tg44/HALE-H8E10/docs/decisions.md

# Design decisions

Short records of the choices made so far and why. Add a new entry rather
than editing an old one when something changes.

## D1. Scope: pad controller first, keybed later

Started as "MPK-mini clone with motorized X32 faders". Motorized faders need
an H-bridge, PID loop, capacitive touch and a ~10 V rail that USB can't
supply from a laptop; they pushed the project into custom power and a much
larger firmware. Dropped for v1. An LPD8-sized board (8 hall keys, 10
encoders, display) is cheap to get wrong and the sensing/encoder/MIDI code
carries straight to a 25-key version.

Every key is a hall key. There are no mechanical/hot-swap switches on the
board; menu and mode functions use the encoder pushes and the keys
themselves.

## D2. Hall-effect keys, MX form factor

Gateron KS-20 magnetic switches (4.1 mm travel, 30 gf, SMD LED window) with
a linear hall sensor on the PCB. Gives velocity (time between two
thresholds), aftertouch (travel past actuation) and rapid trigger. MX
keycaps are fine for pads; a piano feel is explicitly out of scope — if a
playable keybed is wanted later, design a grid with isomorphic layouts
rather than imitate piano geometry.

## D3. Sensor: Honeywell SS39ET (SOT-23)

SOT-23 sits flat on the bottom of the board under the switch and is easy to
solder. Ratiometric output, so it's powered from the same filtered 3.3 V
rail the ADC references. Cheaper clones (OH49E-S, HSS39ET) are the fallback
if stock runs out; HAL9303SO is the higher-sensitivity option.

## D4. MCU: Seeed XIAO ESP32S3 Plus, flush-mounted on the bottom

Needs native USB OTG for class-compliant USB-MIDI, which rules out every
C-series ESP (C3/C5/C6 only have USB-Serial/JTAG; C5 OTG has no IDF driver
as of 2026). S3 gives USB-MIDI + BLE-MIDI + Wi-Fi web UI on one chip. The
Plus exposes 20 GPIO via half-pitch castellations, reachable with an iron
when soldered flush, which is how it's mounted (socketed would leave only
11 pins). It goes on the bottom with the rest of the soldered parts, so the
top of the board carries only switches, encoders and the display.

## D5. External ADC: MCP3208

The S3's ADC is noisy and non-linear at the ends. An 8-channel 12-bit SPI
ADC replaces both the mux and the bad ADC, has a VREF pin for the
ratiometric trick, and is cheap and easy to get. ADS7953 is the 16-channel
upgrade for a 33-key board.

## D6. I/O expansion: 2 × MCP23017

10 encoders × (A, B, push) = 30 inputs. Two MCP23017s on I2C with internal
pull-ups and wired-OR interrupts, 2 pins spare. (Alternative: four chained
74HC165 on SPI, polled at 2 kHz — deterministic, no interrupts; keep in mind
if I2C latency ever shows.) Encoders decode with a Gray-code state table.

## D7. Encoders: all detented push-encoders, 24/24

Mixed detent/smooth was considered (detent for browse, smooth for EQ/macros).
Rejected: smooth encoders are hard to push without a stray step, and all
ten need push (push-to-reset stands in for a centre detent on EQ knobs).
Elektron uses detented push-encoders everywhere, with acceleration for
sweeps and a fine mode for slow trims. Soft-detent Bourns PEC11R-4215F-S0024
or Alps EC11E light-detent; sample both before buying ten.

## D8. LEDs: SK6812MINI-E(A), reverse mount

Reverse-mount so they sit on the bottom with the rest of the SMD and shine
up through a cutout. The -EA and plain -E variants share the footprint;
either works for hand soldering. (-EA is the one a fab's economic assembly
line accepts, which only matters for a later assembled rev.) 3.3 V data
through a 74AHCT1G125 level shifter.

## D9. Display: generic 1.54" 240×240 ST7789, 8-pin

Has a CS pin, so it can share SPI; socketed on a header with four M2
standoffs so a swap is a footprint change. Full mechanical drawing is in
docs/display.md. 0.96" OLEDs were considered and are fine for a settings
display; the IPS panel is the cheap way to look expensive.

## D10. v0 is hand-soldered, all soldering on the bottom

One board, soldered by a person who does SMD professionally. No fab
assembly for v0: it would add setup and feeder fees for a single unit and
tie part choices to one fab's stock list. Everything soldered sits on the
bottom of a 1.2 mm board (SMD and the XIAO); the top has only switches,
encoders and the display socket. Passives are 0603 with hand-solder pads.
LCSC numbers stay in the symbols so an assembled rev remains an option.

## D11. Power from USB via the XIAO

Total draw < 600 mA (S3 Wi-Fi bursts ~400 mA, 20 LEDs dimmed, sensors,
display). 5 V comes from the XIAO's 5V pin; a dedicated 3.3 V LDO on the
board feeds sensors, ADC and display rather than loading the XIAO's small
regulator. Ferrite + caps isolate the analog rail from LED switching noise.

## D12. No bench test; v0 is the test

The sensor–magnet geometry is not measured on a breadboard first. Instead:

- sensor position under the KS-20 is copied from open hall-keyboard designs
  that use the same switch family (minipad, KBHE 75HE), cross-checked
  against the KS-20 drawing;
- magnet polarity doesn't need to be known: the SS39ET rests at VCC/2 and
  swings either way, and per-key calibration records rest and bottom-out;
- the board is cheap and hand-built, so a wrong offset costs one bare PCB
  respin and a re-solder, not an assembly order.

Accepted risk: too little swing, or saturation, on v0. If that happens the
fix is a moved footprint or a different-sensitivity sensor in the same
SOT-23 (D3).

## D13. Schematic and layout grow together

Not "finish the schematic, then lay out". Each part group is collected
(symbol, footprint, 3D model, datasheet), drawn and placed before the next
one starts, and the case is modelled alongside. Mechanical fit is the
tightest constraint on this board (key pitch, knob clearance, display
height, XIAO under the board), so it gets checked from the first placed
part instead of after routing. See docs/plan.md.

## D14. Board thickness 1.6 mm, not 1.2 mm

Replaces the 1.2 mm in D10 and pcb-notes. 1.2 mm was chosen to bring the
sensor closer to the magnet, assuming the signal would be weak. The
datasheets (now in hardware/libs/datasheets/) say the opposite:

- KS-20: 102 ± 15 G at rest, 905 ± 80 G at bottom-out, magnet face
  0.3 mm above the PCB top at bottom-out. The drawing shows a standard
  ~1.6 mm PCB, so 905 G is most likely measured through 1.6 mm.
- SS39ET at 3.3 V: ~0.9 mV/G typical (0.27 mV/G/V nominal, up to
  ~0.35), output limited to ~0.95–1.05 V from either rail, so it clips at
  roughly 520–780 G. Even at 5 V the guaranteed range is only ±650 G.

So the sensor clips over the last part of the travel at 1.6 mm already;
1.2 mm would add roughly 10–40 % more field (dipole estimate) and clip
earlier. 1.6 mm costs nothing and keeps more of the travel linear.
Velocity (two thresholds high in the travel) is unaffected by clipping;
aftertouch range near bottom-out is what's at stake. Still the D12
accepted risk; the remaining fix is a lower-sensitivity sensor (open).

## D15. Sensor: TI DRV5055A3 (replaces D3's SS39ET)

DRV5055A3QDBZR (LCSC C266128), SOT-23, on the 3.3 V analog rail. Datasheet
(TI SBAS640C) at 3.3 V: 15 mV/mT, guaranteed linear range ±88 mT, output
linear to 0.2 V from either rail, VCC/2 at rest. That is ~1.7× the SS39ET's
signal and ~2.5× its room before clipping, in the same pinout.

- Proven setup: KBHE 75HE uses DRV5055A3 at 3.3 V on a 1.6 mm board; HE60
  lists it (and SS39ET) as working with Gateron magnetic switches. Every
  open hall board checked runs its sensors at 3.3 V.
- The field under a 1.6 mm board is probably below Gateron's 905 G: TI app
  note SLYA093 models ~2.1 mm magnet-to-sensor at bottom-out and picks a
  ±80 mT part. So D14's clipping estimate was pessimistic; the SS39ET is
  borderline rather than clearly clipping. Inference, not measured.
- Bipolar on purpose. DRV5056 (unipolar, 2× the swing) was rejected: it
  reads only one pole, and HE60 reports DRV5055A3 as "inverted" with
  Gateron switches, so the pole at the sensor isn't certain. With no bench
  test (D12), a wrong guess would mean eight dead keys. DRV5055 swings
  either way; calibration flips the sign.
- Fallback for clipping: DRV5055A4 (7.5 mV/mT, ±176 mT, C266123), same
  footprint, swap per key. SS39ET (C126669) also fits the same footprint.
- Pinout identical on all three: 1 VCC, 2 OUT, 3 GND. Package bodies
  differ (SS39ET 1.60 × 2.80 mm lead span, DRV5055 TO-236 1.2–1.4 ×
  2.10–2.64 mm), so the footprint uses TI's DBZ land pattern, which holds
  both (see pcb-notes).

Ratiometric still holds: sensors and MCP3208 VREF share the 3.3 V analog
rail (D5).

## D16. Display: 2.79" 428×142 NV3007 bar above the keys (replaces D9's 1.54")

TZT / ShengYang "2.79TFT-SPI" module, [AliExpress
1005012658981762](https://www.aliexpress.com/item/1005012658981762.html).
Drawings and the comparison with the other candidates:
hardware/libs/datasheets/display/ (`2.79/`, `candidates.md`).

- Why: the 1.54" module set the case height and sat in its own column
  beside the keys; with five knobs per row the case hit the print bed
  (256 mm) and the knob pitch was capped at 26. A wide, low bar in a strip
  behind the keys frees that column: the case is ~222 × 83 and the knobs
  get 27 mm. The bar is 1.8× the 1.54"'s area (64.1 × 21.3) and spans the
  four key columns (~107 px per key label).
- Same 8-pin order (GND VDD SCL SDA RES DC CS BL) and 4-wire SPI with CS:
  SPI B in pinout.md stays. VDD 3–5 V with its own 3.3 V regulator; 3.3 V
  logic; backlight 100 mA through an on-board NPN on the BL pin (counts
  against D11's budget).
- Controller is NV3007, not ST7789: drivers exist in Arduino_GFX
  (`Arduino_NV3007`) and as community esp_lcd components
  (`lz00qs/esp_lcd_nv3007`) and LVGL; not in TFT_eSPI or LovyanGFX.
  Datasheet V1.0 in datasheets/display/: VCI 2.8–3.6 V (4.6 abs max),
  IOVCC 1.8–3.6 V; 4-line SPI write cycle ≥ 10 ns (≤ 100 MHz), read
  ≥ 150 ns.
- Mounting: male header soldered straight into the main PCB, no socket.
  The module's back-side parts (≈ 2.6, from the 6.00 max) are taller than
  the header body (2.5), so the module sits on 2 × M2 3.0 mm spacers at its
  two Ø2.5 holes; glass top at ~6.4 above the main PCB.
- Power: header VDD on the **5 V** net. VDD only feeds the module's own
  3.3 V regulator (U1), which supplies the panel and, through 3 Ω, the
  backlight LEDs (Vf ≈ 3.2). From 5 V the backlight gets a full 3.3 V and
  its ~100 mA (PWM) stays off our 3.3 V rail, which also feeds the hall
  sensors (D5). From 3.3 V, U1's dropout leaves ~3.0–3.2 V and the
  backlight runs dim. U1 dissipates ≈ (5 − 3.3) × 0.11 ≈ 0.19 W. Logic
  pins are 3.3 V either way (panel side of U1), no level shifting.
- Not verified with a part in hand. The 1.54" stays documented
  (`display/1.54/`) as the fallback.

## D17. Encoders bolted to the case top: Bourns PEC11R-4215F-S0024

Replaces D7's "PEC11R or Alps EC11E". The printed top has a 2 mm encoder
segment resting on the 6.5 mm encoder bodies; each M7 × 0.75 bushing goes
through a Ø7.4 hole and is clamped with the supplied washer (0.5) and nut
(2.0, 10 AF): 2.0 + 0.5 + 2.0 = 4.5 of the 5 mm thread. Push and twist
forces go into the case, not the solder joints (the push switch alone is
4–6 N per press), and the ten nuts lock the PCB to the case.

- The Alps EC11E has a plain, unthreaded collar (catalogues in
  datasheets/encoder/), so it can't be bolted; dropped.
- PEC11R-4215F-S0024: 24 detents / 24 pulses (one pulse per click, as D7
  assumed), 15 mm flatted shaft (tip 21.5 above the PCB, 7 mm D-flat),
  lighter detent than the EC11E. LCSC C143790.
- Still worth a sample before ordering ten (D7's point about feel).

## D18. Panel layout and a stepped, printed top

Source of truth: `case/layout.js` (every number below comes from there);
reasoning and sources: docs/layout-references.md.

- Left block: 2 × 4 keys at the front (19.05 pitch), the D16 display in a
  strip behind them. Right block: 2 × 5 encoders, 27 mm along a row
  (Intech EN16 ≈ 26.75); the rows line up with the front key row and the
  display centre line.
- Top is one printed part with two heights: the key area is the KS-20
  plate (1.5 thick, top 5.0 above the PCB, fixed by the switch clips); the
  display and encoder areas are flush at 8.5 (encoder bodies 6.5 + 2.0).
  The step has a near-full 3.5 mm fillet. A pressed keycap bottoms out at
  7.5, so the step sits outside the keycap footprint (+0.5).
- Spacing rules in layout.js: window → back edge equals front keycap →
  front edge (7.0); a 5.3 mm flat strip between the fillet and the window;
  2.0 walls and floor (PLA/PETG, 0.4 nozzle).
- The case must fit the owner's printer bed, 256 × 235 (4 mm spare for a
  skirt); layout.js refuses to build a bigger one. Now 222.0 × 82.7.

## D19. Sensor RC filter at the ADC, as resistor arrays

The 1 kΩ of each sensor's RC filter moves from the key cell to the ADC,
next to its 100 nF (replaces pcb-notes' "1 kΩ series near the sensor").

- The filter acts where the signal is sampled, and the long trace from
  the key is driven by the sensor's low-impedance output instead of being
  a 1 kΩ node, so it picks up less LED/I2C noise.
- With all eight resistors in one place they fit two 4-resistor arrays
  (Uni-Royal 4D03WGJ0102T5E, LCSC C20197, convex 0603×4: 3.2 × 1.6, 0.8
  pitch — datasheet in `datasheets/adc/`). An array can't sit next to
  sensors 19 mm apart, so this only works at the ADC.
- Cost: the sensor output now sees the trace capacitance (a few pF) with
  no resistor. TI warns against a *capacitor* directly on the output
  (§7.1.3); the datasheet gives no maximum load, so a few pF being fine is
  judgement, not a TI figure.

## D20. MCP23017 bit 7 is output-only: two encoder pushes go to the XIAO

Since datasheet revision D (2022), GPA7 and GPB7 of the MCP23017 are
output-only (the I2C part only; the SPI MCP23S17 keeps them). Two
expanders give 28 inputs, not 32, and the encoders need 30.

- Two push switches go straight to XIAO GPIOs (16 of 20 used, 4 spare).
  No extra parts. ENC1, top left, is the settings button, and the owner
  wants it on the MCU directly, so it is always one of the two.
- Rejected: MCP23S17 (moves the expanders onto the ADC's SPI bus) and a
  third MCP23017 (another SSOP-28 to hand-solder for two pins).
- The exact expander pin per encoder is left for layout, under the rules
  in pinout.md (A/B of one encoder on one port, bit 7 unused).
- The bit-7 pins remain usable as outputs; RST_LCD could move there if
  XIAO pins ever run short.

## D21. Settled at the schematic review (2026-10-15)

- **Digital 3.3 V comes from the XIAO.** The expanders, I2C and CS
  pull-ups run on the XIAO's 3V3_OUT (`+3.3V`), the same rail as the
  ESP32's I/O. Our LDO feeds only the analog rail (`+3.3VA`: sensors,
  MCP3208) through the ferrite. The two regulators are never tied
  together. The digital load is a few mA on top of the ESP32.
- **Hall footprint: KiCad's stock SOT-23**, not a hand-drawn TI DBZ
  pattern. Its pads span 0.2–1.675 mm from the centre, which holds the
  DRV5055, the A4 spare and the wider SS39ET alike (pcb-notes).
- **Pin assignment** as in pinout.md; the second MCU encoder push is
  ENC6 (front row, left), next to ENC1.
- **LED chain**: one serpentine run, keys → encoders; the last DOUT is the
  chain end. (The 2 status LEDs drawn here were dropped, D22.)

## D22. No status LEDs: 18 LEDs, ENC1 first in the chain

The two status LEDs (README's "2 status TBD") are dropped. The 2.79"
display shows status and connection; the 18 key and encoder LEDs are all
firmware-mapped and can show anything else.

- The one case the display can't cover — before it's initialised, or if
  it's dead — goes to **ENC1's LED** (the settings encoder): boot state,
  fault blink codes, recovery / Wi-Fi AP. Firmware rule: status wins
  before the display is up and on errors; otherwise it is a normal
  encoder LED.
- That only works if ENC1's LED is **first in the chain**: data can't get
  past a dead LED, so everything after one goes dark. The chain order is
  still open (plan A7); it now starts at ENC1.
- Considered: keeping the two as unfitted footprints at the chain's end
  (a free later option) and a lit "8" in a printed logo. Dropped for
  simplicity; there are plenty of LEDs.
- Fewer parts: 2 LEDs and 2 × 100 nF less, and ~70 mA less worst-case
  current.

## D23. 5 V split into switched rails; CS pull-ups follow the rails

The single `+5V` net is split behind two TI TPS22810 load switches
(2026-10-19):

- `+5V_AUX` (U1003, EN_AUX on GPIO4): the display and the ME6211 that
  makes `+3.3VA` (sensors, MCP3208). `+5V_LED` (U1004, EN_LED on GPIO42):
  the 18 LEDs and the 74AHCT1G125. `+5V` itself (VBUS) feeds only the two
  switches.
- Why: everything stays off while the ESP32 boots and enumerates, the
  LEDs can't flash garbage from a floating LED_DATA during reset (EN has a
  10 kΩ pull-down, so a reset drops the rail), and the firmware can
  power-cycle the display and the analog side.
- CT = 100 nF: ~9 ms soft start, ~20 mA inrush into the LED rail's 42 µF.
  That replaces D11/pcb-notes' 220 µF bulk electrolytic (4 × 10 µF stay).
  QOD tied to VOUT discharges a rail quickly when it's switched off.
- Pull-ups now sit on the rail of the chip they protect: ADC_CS to
  `+3.3VA` (R2001); LCD_CS has none. A pull-up to the always-on `+3.3V`
  would feed an unpowered chip through its CS pin.
- Cost: two GPIOs. Only GPIO3 (strapping) and GPIO43 (UART0 TX) are left
  free, and ADC_CS moved to GPIO44 (UART0 RX), so the debug console is
  TX-only.
- Firmware rules that come with it (pcb-notes, 5 V rails): switch a rail
  on and wait ≥ 10 ms before driving its chips' pins; make those pins
  inputs before switching off; cap LED brightness for a 500 mA port.
- Considered: EN_AUX on an RC to `+5V` (always on, soft start only) to
  save a GPIO. Kept the GPIO for now; it's the first thing to give back if
  a pin is needed.

## D24. Mounting holes: screws around the key block, pins elsewhere

12 holes on a grid (positions in pcb-notes, "Mounting holes"), 7 screws
and 5 pins (2026-10-19).

- The KS-20s are clipped into the plate but not soldered, so nothing else
  holds the left half of the board against the top. The key block gets
  screws on all four sides (two on the keys/display step wall, the step
  wall corner and its front end, the front-left corner). Their bosses are
  3.5 mm, the gap the switch housing fills, so the screws set the
  magnet-to-sensor distance.
- The encoder half is already clamped by the ten M7 nuts (D17): two
  screws hold the tray, the rest are pins.
- Pins where a boss doesn't fit: H1002 (2.3 mm to the switch courtyards)
  and H1012 under the display, where the top can't reach the board. The
  latter is a tray pin that supports the XIAO/USB-C corner.
- Grid: rows 65.2 / 95.8 / 134.8 (edge rows 4.04 mm in, symmetric about
  the board centre), columns on the key-block centre ± 16.5, the step
  wall and the encoder gaps, so the case model can use the same numbers.
  Corner holes sit at least 2.7 mm from the R5 corner arc.

## D25. Firmware: PlatformIO + pioarduino, Arduino framework; USB-MIDI last

Settled 2026-10-22, before C0. Replaces "ESP-IDF (or Arduino-ESP32)" in
firmware/README.md. Details in firmware/docs/.

- C++, not Rust. esp-hal (Rust) is usable on the S3, but there is no
  NV3007 driver, BLE-MIDI and the web page would be written by hand, and
  board bring-up should run on known-good library code.
- PlatformIO for the workflow (already used in luminotaxis), through the
  pioarduino fork: stock `platform-espressif32` is stuck on Arduino-ESP32
  2.x. The platform is pinned to a release tag.
- Arduino framework, because the planned libraries (Arduino_GFX
  `Arduino_NV3007`, BLE-MIDI, ESPAsyncWebServer) are Arduino libraries.
  `framework = arduino, espidf` stays open if an IDF setting is needed.
- TinyUSB takes over the USB port and with it the serial console and
  auto-reset flashing. So development runs on the `xiao` env
  (USB-Serial-JTAG), MIDI goes to the log / BLE, and USB-MIDI is switched
  on last (`xiao-usbmidi`, C13), after OTA works. A short C1 spike checks
  the mode switch and recovery early. A one-boot "reboot without MIDI"
  menu item is planned (unverified until C1).

## D26. Mini test board (H4E2) before v0; amends D12

Settled 2026-10-24. D12 ("no bench test, v0 is the test") no longer holds
in full: a small board is built first.

- What it tests: the footprints (KS-20 pegs with the SOT-23 sensor
  under it, the SK6812MINI-EA reverse-mount cutout, PEC11R, MCP3208
  SOIC-16, the resistor array), the hall circuit with the D19 RC filter
  at the ADC, the LDO + ferrite analog rail, encoders and the display.
  Four keys leave room to put the DRV5055A3, the A4 spare and the SS39ET
  side by side under the same switch.
- Not tested: the TPS22810 load switches (no EU distributor stock on
  2026-10-22).
- Layout: the H8E10's left 2×2 keys and the 2.79" display at the same
  positions relative to each other, plus 1–4 encoders. Same part sizes and
  spacing rules as the big board. Picked: `h4e2-stack`, two encoders
  stacked in the free key slot (27 apart, case 91.0 × 82.7, no wider
  than the display needs). The key well's wall leaves the same gap right
  of the keys as the case edge does left of them (7.9), and the column is
  centred on the flat top between the step slope and the case edge (9.8
  each side). Accepted cost: the back knob is 4.9 mm in
  front of the screen window and hides its lower-right corner unless
  viewed from steeply above; the encoder positions differ from the
  H8E10's, so the mini doesn't check the big board's encoder/step-wall
  fit. The other candidates stay in `case/mini/` (`VARIANTS`).
- Sourcing: as few LCSC line types as possible. Since 2026-07-01 a
  parcel under €150 from outside the EU pays €3 duty per tariff line, so
  loose passives from LCSC cost more in duty than in parts. Mouser has
  everything but the LEDs and the TPS22810; the LED comes from LCSC
  because the footprint test needs the real part.
- The case files were reorganised for it: shared sizes and builders in
  `case/lib/`, the full board in `case/h8e10/` (D18's `case/layout.js` is
  now `case/h8e10/layout.js`, spacing numbers in `case/lib/parts.js`),
  the mini in `case/mini/`. Its KiCad project is `hardware/H4E2/`.

## D27. Mini assembly: screws on the right, nothing on the left

Settled 2026-10-25, for the mini (D26). Replaces D24's bosses there; the
H8E10 keeps D24 for now.

- D24's 3.5 mm bosses hang below the top's underside. The top is printed
  bottom-up (top layer last, for the finish), so they would be the first
  layer and leave the switch plate in the air. The same holds for the
  H8E10's key-area bosses (H1001, H1003–H1006): that needs rethinking
  before v0.
- Left side: no room for inserts (the switch plate is 1.5 mm, the screen
  strip is hollow over the glass) and no screws near the sensors. The top
  just rests on the tray walls there, as everywhere: the screws and nuts
  already fix it in x, y and z, and key presses push down onto the walls.
  An L-shaped tray wall without a lip was tried and dropped: it held
  nothing the plain wall doesn't. Known weak spot: pulling a keycap lifts
  the front-left of the switch plate (about 70 mm from the nearest
  fixing); hold the board down. A hooked left wall can follow if that is
  a problem in practice.
- Right side: two M2 screws from under the tray into heat-set inserts in
  the top's solid encoder area (front corner, and in front of the screen
  glass), plus the two encoder nuts. Brass or nylon screws.
- The PCB is not screwed: tray towers hold it from below (centre of the
  key block, front-left corner, the screw columns), two of them with a
  pin through a PCB hole under the screen to locate it. Its bottom side
  needs Ø6 keep-out spots there.
- Assembly, all straight down: tray, PCB on its towers, top (on the tray
  walls, encoder bushings through their holes), keys clipped in, encoder
  nuts, screws from below.
- Insert hole Ø3.2 × 4 is a typical value, not from the insert's
  datasheet.
