tg44/HALE-H8E10/firmware/docs/features/display/tasks.md

# Display tasks

## Now

## Next

- [ ] decide the drawing layer that renders in `native` (screens to PNG)
- [ ] first screens: play, status

## Needs the board

- [ ] C6: init, rotation, backlight (LCD-M1 … LCD-M4)

## Done
