tg44/HALE-H8E10/firmware/docs/features/encoders/tasks.md

# Encoder tasks

## Now

## Next

- [ ] Gray-code decoder with tests on recorded pin sequences
- [ ] acceleration and push logic with tests

## Needs the board

- [ ] C7: expander setup, interrupts, all ten encoders (ENC-M1 … ENC-M5)

## Done
