tg44/HALE-H8E10/firmware/docs/features/keys/tasks.md

# Key tasks

## Now

## Next

- [ ] simulated sensor traces (rest, slow press, fast press, partial
      press, hold, release) as test fixtures
- [ ] key engine against those traces in `native`

## Needs the board

- [ ] C8: ADC raw dump, channel map, swing per key (KEY-M1 … KEY-M4, KEY-M6)
- [ ] record real traces, replace the simulated fixtures
- [ ] C9: thresholds from real data
- [ ] re-check in the case (KEY-M5)

## Done
