tg44/HALE-H8E10/firmware/docs/features/leds/tasks.md

# LED tasks

## Now

## Next

- [ ] status light patterns as data, testable in `native`
- [ ] brightness cap as a function of the frame, testable in `native`

## Needs the board

- [ ] C5: RMT driver, rail on/off, chain walk (LED-M1 … LED-M4)
- [ ] measure current, set the cap (SYS-M11)

## Done
