tg44/HALE-H8E10/firmware/docs/features/midi/tasks.md

# MIDI tasks

## Now

## Next

- [ ] C1: USB-MIDI spike (with system)
- [ ] output interface + log output, tests in `native`
- [ ] message encoding (MIDI bytes, USB-MIDI packets, BLE-MIDI packets)
      with tests
- [ ] C3: BLE-MIDI on a bare XIAO
- [ ] C10: mapping, tests in `native`

## Needs the board

- [ ] C13: USB-MIDI output (needs OTA, see usb.md)

## Done
