tg44/HALE-H8E10/firmware/docs/features/settings/checks.md

# Settings checks

| ID | Check | How | Expected (source) | Board | Result | Date |
|---|---|---|---|---|---|---|
| SET-M1 | Settings survive a power cycle | change a setting, unplug, plug in | setting kept | | | |
| SET-M2 | Recovery boot | hold ENC1 while plugging in | defaults + Wi-Fi AP; stored settings intact until confirmed (on-device-menu.md) | | | |
| SET-M3 | Settings mode by hand | enter, move, change, leave | works as on-device-menu.md; no MIDI sent while in it | | | |
