tg44/HALE-H8E10/firmware/docs/features/settings/tasks.md

# Settings tasks

## Now

## Next

- [ ] C2: settings model + serialization, tests in `native`
- [ ] C2: NVS storage on a bare XIAO
- [ ] menu state machine in `native` (from on-device-menu.md)

## Needs the board

- [ ] C11: settings mode on the device (keys, ENC1, display, LEDs)

## Done
