tg44/HALE-H8E10/firmware/docs/features/web/checks.md

# Web checks

| ID | Check | How | Expected (source) | Board | Result | Date |
|---|---|---|---|---|---|---|
| WEB-M1 | Wi-Fi signal in the case | RSSI on the status page, case closed, a few metres from the router | OPEN: target RSSI; record it | | | |
| WEB-M2 | OTA update | upload a new build over Wi-Fi | new version boots, settings kept | | | |
| WEB-M3 | Access point | recovery boot, connect a phone | settings page reachable | | | |
