tg44/HALE-H8E10/firmware/docs/features/web/tasks.md

# Web tasks

## Now

## Next

- [ ] C4: Wi-Fi connect + AP on a bare XIAO
- [ ] C4: OTA update on a bare XIAO
- [ ] C4: settings page skeleton against the settings model
- [ ] logs over Wi-Fi

## Needs the board

- [ ] C12: MIDI map editor, calibration view

## Done
