tg44/HALE-H8E10/docs/img/display-1.54-front.png

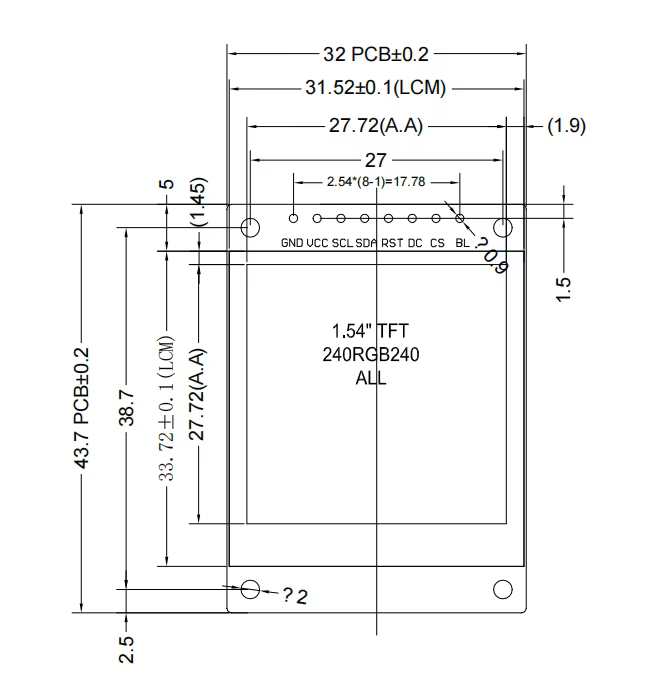
docs/img/display-1.54-front.png
