tg44/HALE-H8E10/hardware/H4E2/H4E2.kicad_pcb

## KiCad design hardware/H4E2/H4E2.kicad_pcb (2026-10-26)

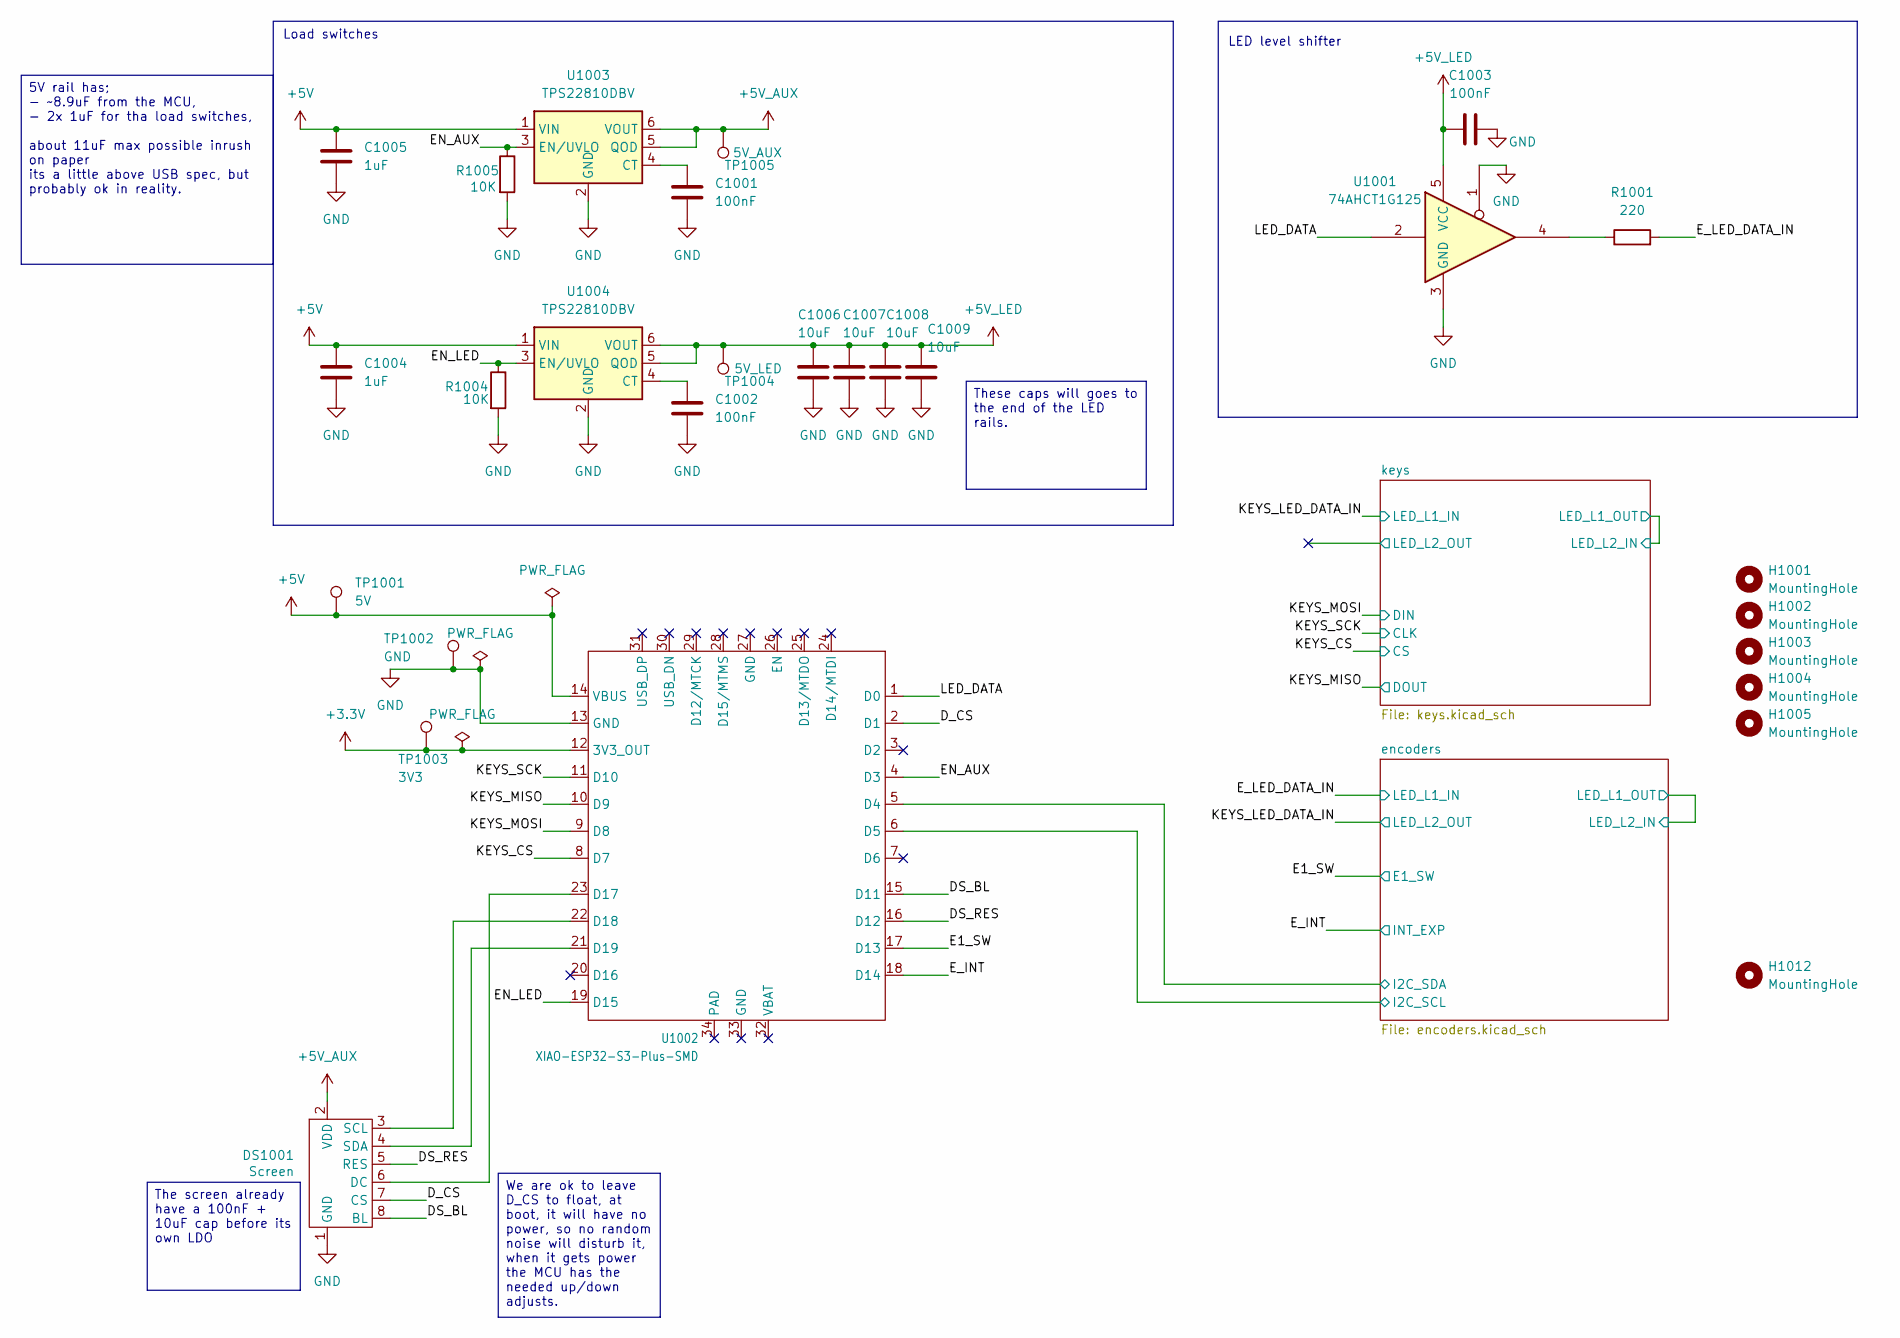
[picture p3: schematic H4E2.kicad_sch, HALE-H4E2]

Parts:
C1001, C1002, C1003: 100nF; C_0603_1608Metric_Pad1.08x0.95mm_HandSolder; LCSC C14663
C1004, C1005: 1uF; C_0603_1608Metric_Pad1.08x0.95mm_HandSolder; LCSC C15849
C1006, C1007, C1008, C1009: 10uF; C_0805_2012Metric_Pad1.18x1.45mm_HandSolder; LCSC C15850
DS1001: Screen; Display_2.79_NV3007
H1001, H1002, H1003, H1004, H1005, H1012: MountingHole; MountingHole_2.2mm_M2
R1001: 220; R_0603_1608Metric_Pad0.98x0.95mm_HandSolder; LCSC C22962
R1004, R1005: 10K; R_0603_1608Metric_Pad0.98x0.95mm_HandSolder; LCSC C25804
TP1001: 5V; TestPoint_Pad_D2.0mm
TP1002: GND; TestPoint_Pad_D2.0mm
TP1003: 3V3; TestPoint_Pad_D2.0mm
TP1004: 5V_LED; TestPoint_Pad_D2.0mm
TP1005: 5V_AUX; TestPoint_Pad_D2.0mm
U1001: 74AHCT1G125; SOT-23-5; LCSC C7484
U1002: XIAO-ESP32-S3-Plus-SMD; LCSC C47997983
U1003, U1004: TPS22810DBV; SOT-23-6; LCSC C205990

Connections:
+3.3V: TP1003.1 (1_1), U1002.12 (3V3_OUT); also elsewhere on the board
+5V: C1004.1, C1005.1, TP1001.1 (1_1), U1002.14 (VBUS), U1003.1 (VIN), U1004.1 (VIN)
+5V_AUX: DS1001.2 (VDD), TP1005.1 (1_1), U1003.5 (QOD), U1003.6 (VOUT); also elsewhere on the board
+5V_LED: C1003.2, C1006.1, C1007.1, C1008.1, C1009.1, TP1004.1 (1_1), U1001.5 (VCC), U1004.5 (QOD), U1004.6 (VOUT); also elsewhere on the board
/DS_BL: DS1001.8 (BL), U1002.15 (D11)
/DS_RES: DS1001.5 (RES), U1002.16 (D12)
/D_CS: DS1001.7 (CS), U1002.2 (D1)
/E1_SW: U1002.17 (D13); also elsewhere on the board
/EN_AUX: R1005.1, U1002.4 (D3), U1003.3 (EN/UVLO)
/EN_LED: R1004.1, U1002.19 (D15), U1004.3 (EN/UVLO)
/E_INT: U1002.18 (D14); also elsewhere on the board
/E_LED_DATA_IN: R1001.2; also elsewhere on the board
/KEYS_CS: U1002.8 (D7); also elsewhere on the board
/KEYS_MISO: U1002.10 (D9); also elsewhere on the board
/KEYS_MOSI: U1002.9 (D8); also elsewhere on the board
/KEYS_SCK: U1002.11 (D10); also elsewhere on the board
/LED_DATA: U1001.2, U1002.1 (D0)
/encoders/I2C_SCL: U1002.6 (D5); also elsewhere on the board
/encoders/I2C_SDA: U1002.5 (D4); also elsewhere on the board
GND: C1001.2, C1002.2, C1003.1, C1004.2, C1005.2, C1006.2, C1007.2, C1008.2, C1009.2, DS1001.1 (GND), R1004.2, R1005.2, TP1002.1 (1_1), U1001.1, U1001.3 (GND), U1002.13 (GND), U1003.2 (GND), U1004.2 (GND); also elsewhere on the board
unnamed: DS1001.6 (DC), U1002.23 (D17)
unnamed: DS1001.3 (SCL), U1002.22 (D18)
unnamed: DS1001.4 (SDA), U1002.21 (D19)
unnamed: R1001.1, U1001.4
unnamed: C1001.1, U1003.4 (CT)
unnamed: C1002.1, U1004.4 (CT)

Notes on the sheet:
The screen already have a 100nF + 10uF cap before its own LDO
We are ok to leave D_CS to float, at boot, it will have no power, so no random noise will disturb it, when it gets power the MCU has the needed up/down adjusts.
These caps will goes to the end of the LED rails.
5V rail has; - ~8.9uF from the MCU, - 2x 1uF for tha load switches, about 11uF max possible inrush on paper its a little above USB spec, but probably ok in reality.
Load switches
LED level shifter

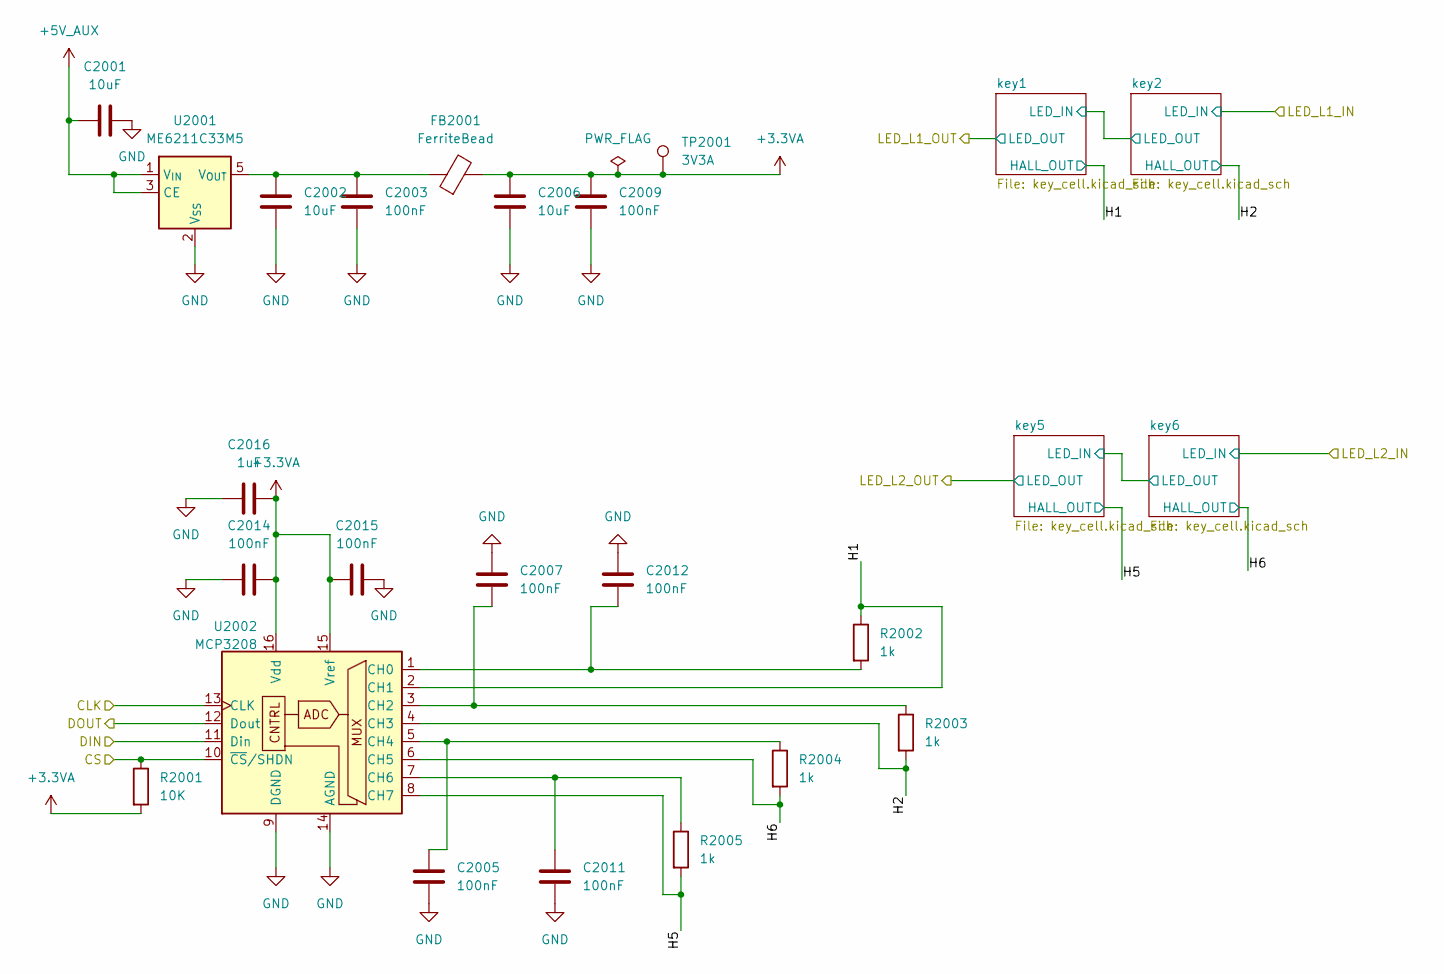
[picture p4: schematic keys.kicad_sch]

Parts:
C2001, C2002, C2006: 10uF; C_0805_2012Metric_Pad1.18x1.45mm_HandSolder; LCSC C15850
C2003, C2005, C2007, C2009, C2011, C2012, C2014, C2015: 100nF; C_0603_1608Metric_Pad1.08x0.95mm_HandSolder; LCSC C14663
C2016: 1uF; C_0603_1608Metric_Pad1.08x0.95mm_HandSolder; LCSC C15849
FB2001: FerriteBead; L_0603_1608Metric_Pad1.05x0.95mm_HandSolder; LCSC C1002
R2001: 10K; R_0603_1608Metric_Pad0.98x0.95mm_HandSolder; LCSC C25804
R2002, R2003, R2004, R2005: 1k; R_0603_1608Metric_Pad0.98x0.95mm_HandSolder
TP2001: 3V3A; TestPoint_Pad_D2.0mm
U2001: ME6211C33M5; SOT-23-5; LCSC C82942
U2002: MCP3208; SOIC-16_3.9x9.9mm_P1.27mm; LCSC C626764

Connections:
+3.3VA: C2006.1, C2009.1, C2014.1, C2015.2, C2016.1, FB2001.2, R2001.2, TP2001.1 (1_1), U2002.15 (Vref), U2002.16 (Vdd); also elsewhere on the board
+5V_AUX: C2001.1, U2001.1 (V_{IN}), U2001.3 (CE); also elsewhere on the board
/KEYS_CS: R2001.1, U2002.10 (~CS/SHDN); also elsewhere on the board
/KEYS_MISO: U2002.12 (Dout); also elsewhere on the board
/KEYS_MOSI: U2002.11 (Din); also elsewhere on the board
/KEYS_SCK: U2002.13 (CLK); also elsewhere on the board
/keys/H1: R2002.1, U2002.2 (CH1); also elsewhere on the board
/keys/H2: R2003.2, U2002.4 (CH3); also elsewhere on the board
/keys/H5: R2005.2, U2002.8 (CH7); also elsewhere on the board
/keys/H6: R2004.2, U2002.6 (CH5); also elsewhere on the board
GND: C2001.2, C2002.2, C2003.2, C2005.1, C2006.2, C2007.2, C2009.2, C2011.1, C2012.2, C2014.2, C2015.1, C2016.2, U2001.2 (V_{SS}), U2002.9 (DGND), U2002.14 (AGND); also elsewhere on the board
unnamed: C2002.1, C2003.1, FB2001.1, U2001.5 (V_{OUT})
unnamed: C2012.1, R2002.2, U2002.1 (CH0)
unnamed: C2007.1, R2003.1, U2002.3 (CH2)
unnamed: C2005.2, R2004.1, U2002.5 (CH4)
unnamed: C2011.2, R2005.1, U2002.7 (CH6)

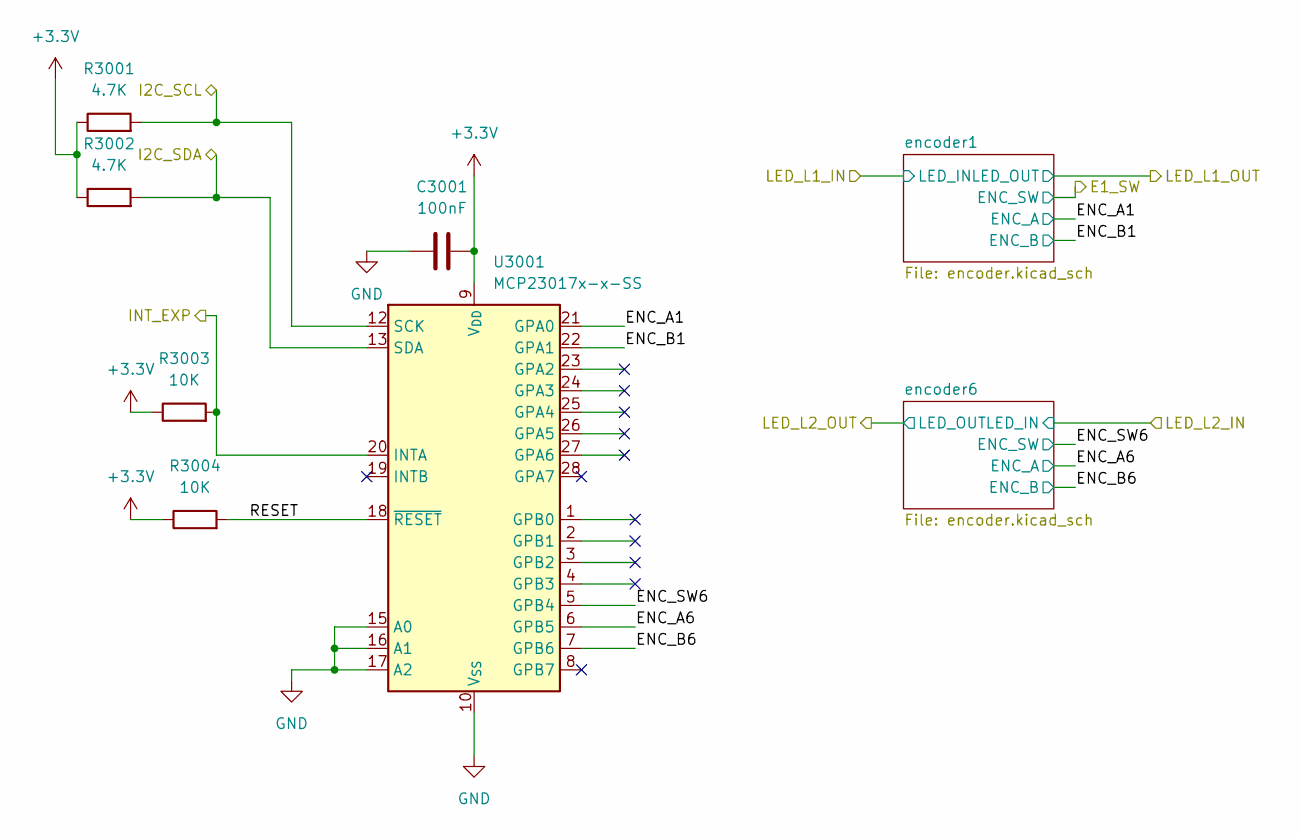
[picture p5: schematic encoders.kicad_sch]

Parts:
C3001: 100nF; C_0603_1608Metric_Pad1.08x0.95mm_HandSolder; LCSC C14663
R3001, R3002: 4.7K; R_0603_1608Metric_Pad0.98x0.95mm_HandSolder; LCSC C23162
R3003, R3004: 10K; R_0603_1608Metric_Pad0.98x0.95mm_HandSolder; LCSC C25804
U3001: MCP23017x-x-SS; SSOP-28_5.3x10.2mm_P0.65mm; LCSC C506653

Connections:
+3.3V: C3001.2, R3001.1, R3002.1, R3003.1, R3004.1, U3001.9 (V_{DD}); also elsewhere on the board
/E_INT: R3003.2, U3001.20 (INTA); also elsewhere on the board
/encoders/ENC_A1: U3001.21 (GPA0); also elsewhere on the board
/encoders/ENC_A6: U3001.6 (GPB5); also elsewhere on the board
/encoders/ENC_B1: U3001.22 (GPA1); also elsewhere on the board
/encoders/ENC_B6: U3001.7 (GPB6); also elsewhere on the board
/encoders/ENC_SW6: U3001.5 (GPB4); also elsewhere on the board
/encoders/I2C_SCL: R3001.2, U3001.12 (SCK); also elsewhere on the board
/encoders/I2C_SDA: R3002.2, U3001.13 (SDA); also elsewhere on the board
/encoders/RESET: R3004.2, U3001.18 (~RESET)
GND: C3001.1, U3001.10 (V_{SS}), U3001.15 (A0), U3001.16 (A1), U3001.17 (A2); also elsewhere on the board

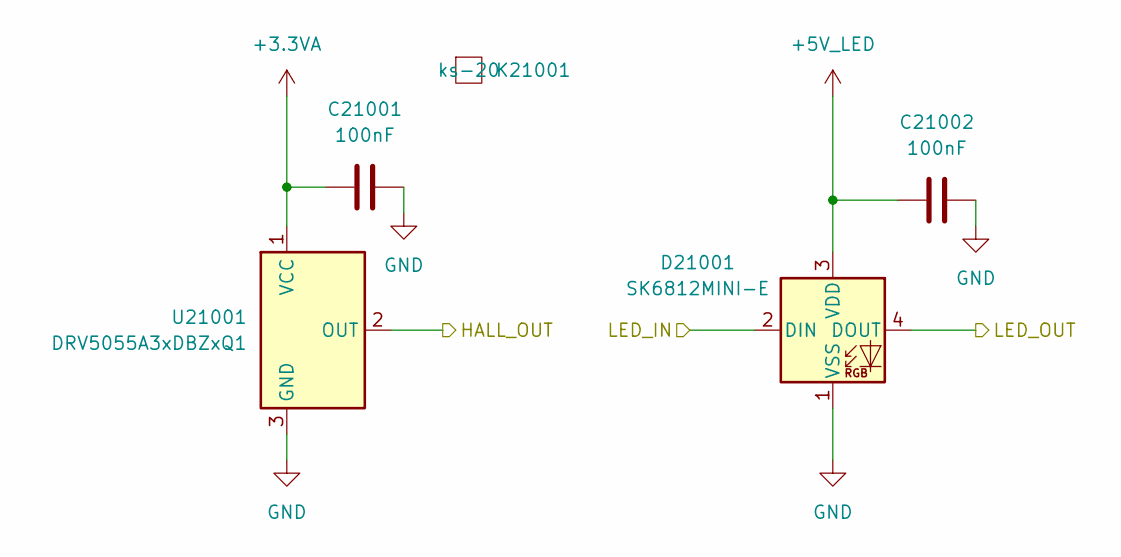
[picture p6: schematic key_cell.kicad_sch]

Parts:
C21001, C21002: 100nF; C_0603_1608Metric_Pad1.08x0.95mm_HandSolder; LCSC C14663
D21001: SK6812MINI-E; LED_SK6812MINI-E_3.2x2.8mm_P1.5mm_ReverseMount; LCSC C5149201
K21001: ks-20; Gateron_KS-20
U21001: DRV5055A3xDBZxQ1; SOT-23; LCSC C266128

Connections:
+3.3VA: C21001.1, U21001.1 (VCC); also elsewhere on the board
+5V_LED: C21002.1, D21001.3 (VDD); also elsewhere on the board
/keys/H1: U21001.2 (OUT); also elsewhere on the board
/keys/LED_L1_OUT: D21001.4 (DOUT); also elsewhere on the board
/keys/key1/LED_IN: D21001.2 (DIN); also elsewhere on the board
GND: C21001.2, C21002.2, D21001.1 (VSS), U21001.3 (GND); also elsewhere on the board

Parts of its further copies:
C22001, C22002, C25001, C25002, C26001, C26002: 100nF; C_0603_1608Metric_Pad1.08x0.95mm_HandSolder; LCSC C14663
D22001, D25001, D26001: SK6812MINI-E; LED_SK6812MINI-E_3.2x2.8mm_P1.5mm_ReverseMount; LCSC C5149201
K22001, K25001, K26001: ks-20; Gateron_KS-20
U22001, U25001, U26001: DRV5055A3xDBZxQ1; SOT-23; LCSC C266128

Connections of its further copies:
+3.3VA: C22001.1, C25001.1, C26001.1, U22001.1 (VCC), U25001.1 (VCC), U26001.1 (VCC); also elsewhere on the board
+5V_LED: C22002.1, C25002.1, C26002.1, D22001.3 (VDD), D25001.3 (VDD), D26001.3 (VDD); also elsewhere on the board
/KEYS_LED_DATA_IN: D22001.2 (DIN); also elsewhere on the board
/keys/H2: U22001.2 (OUT); also elsewhere on the board
/keys/H5: U25001.2 (OUT); also elsewhere on the board
/keys/H6: U26001.2 (OUT); also elsewhere on the board
/keys/LED_L1_OUT: D26001.2 (DIN); also elsewhere on the board
/keys/LED_L2_OUT: D25001.4 (DOUT)
/keys/key1/LED_IN: D22001.4 (DOUT); also elsewhere on the board
/keys/key5/LED_IN: D25001.2 (DIN), D26001.4 (DOUT)
GND: C22001.2, C22002.2, C25001.2, C25002.2, C26001.2, C26002.2, D22001.1 (VSS), D25001.1 (VSS), D26001.1 (VSS), U22001.3 (GND), U25001.3 (GND), U26001.3 (GND); also elsewhere on the board

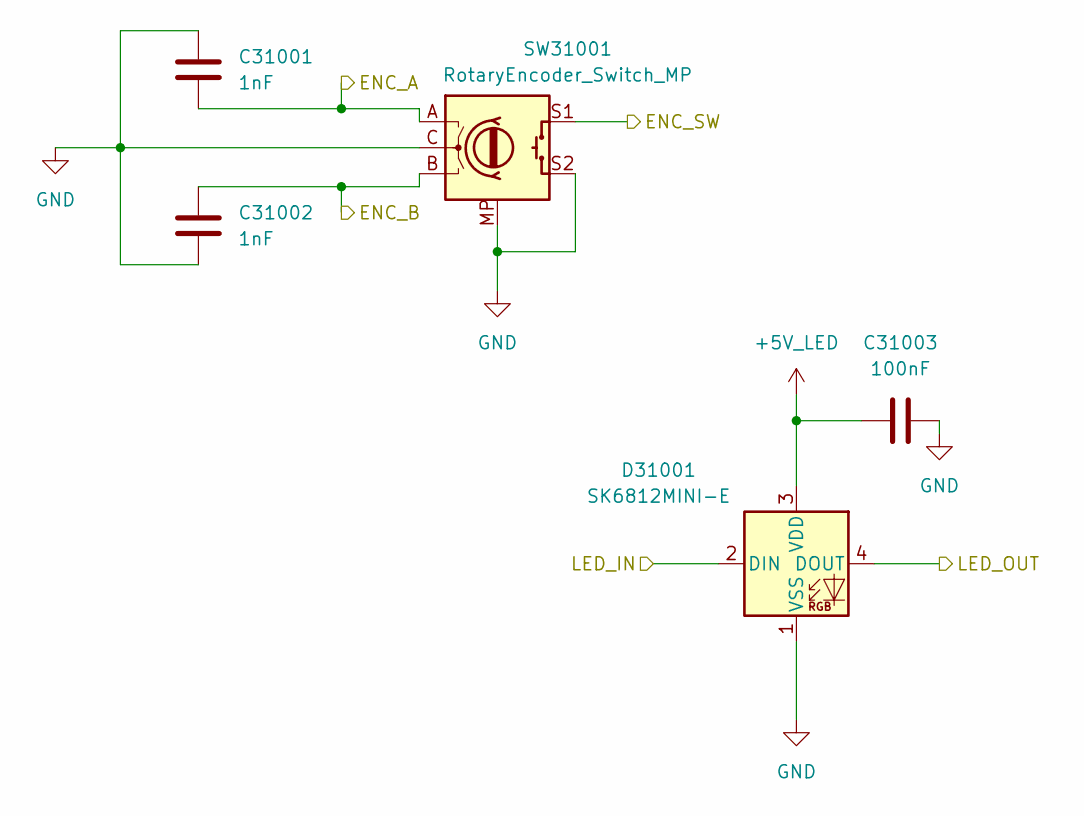
[picture p7: schematic encoder.kicad_sch]

Parts:
C31001, C31002: 1nF; C_0603_1608Metric_Pad1.08x0.95mm_HandSolder; LCSC C1588
C31003: 100nF; C_0603_1608Metric_Pad1.08x0.95mm_HandSolder; LCSC C14663
D31001: SK6812MINI-E; LED_SK6812MINI-E_3.2x2.8mm_P1.5mm_ReverseMount; LCSC C5149201
SW31001: RotaryEncoder_Switch_MP; RotaryEncoder_Alps_EC12E-Switch_Vertical_H20mm

Connections:
+5V_LED: C31003.1, D31001.3 (VDD); also elsewhere on the board
/E1_SW: SW31001.S1; also elsewhere on the board
/E_LED_DATA_IN: D31001.2 (DIN); also elsewhere on the board
/encoders/ENC_A1: C31001.2, SW31001.A; also elsewhere on the board
/encoders/ENC_B1: C31002.1, SW31001.B; also elsewhere on the board
/encoders/LED_L1_OUT: D31001.4 (DOUT); also elsewhere on the board
GND: C31001.1, C31002.2, C31003.2, D31001.1 (VSS), SW31001.C, SW31001.MP, SW31001.S2; also elsewhere on the board

Parts of its further copies:
C36001, C36002: 1nF; C_0603_1608Metric_Pad1.08x0.95mm_HandSolder; LCSC C1588
C36003: 100nF; C_0603_1608Metric_Pad1.08x0.95mm_HandSolder; LCSC C14663
D36001: SK6812MINI-E; LED_SK6812MINI-E_3.2x2.8mm_P1.5mm_ReverseMount; LCSC C5149201
SW36001: RotaryEncoder_Switch_MP; RotaryEncoder_Alps_EC12E-Switch_Vertical_H20mm

Connections of its further copies:
+5V_LED: C36003.1, D36001.3 (VDD); also elsewhere on the board
/KEYS_LED_DATA_IN: D36001.4 (DOUT); also elsewhere on the board
/encoders/ENC_A6: C36001.2, SW36001.A; also elsewhere on the board
/encoders/ENC_B6: C36002.1, SW36001.B; also elsewhere on the board
/encoders/ENC_SW6: SW36001.S1; also elsewhere on the board
/encoders/LED_L1_OUT: D36001.2 (DIN); also elsewhere on the board
GND: C36001.1, C36002.2, C36003.2, D36001.1 (VSS), SW36001.C, SW36001.MP, SW36001.S2; also elsewhere on the board

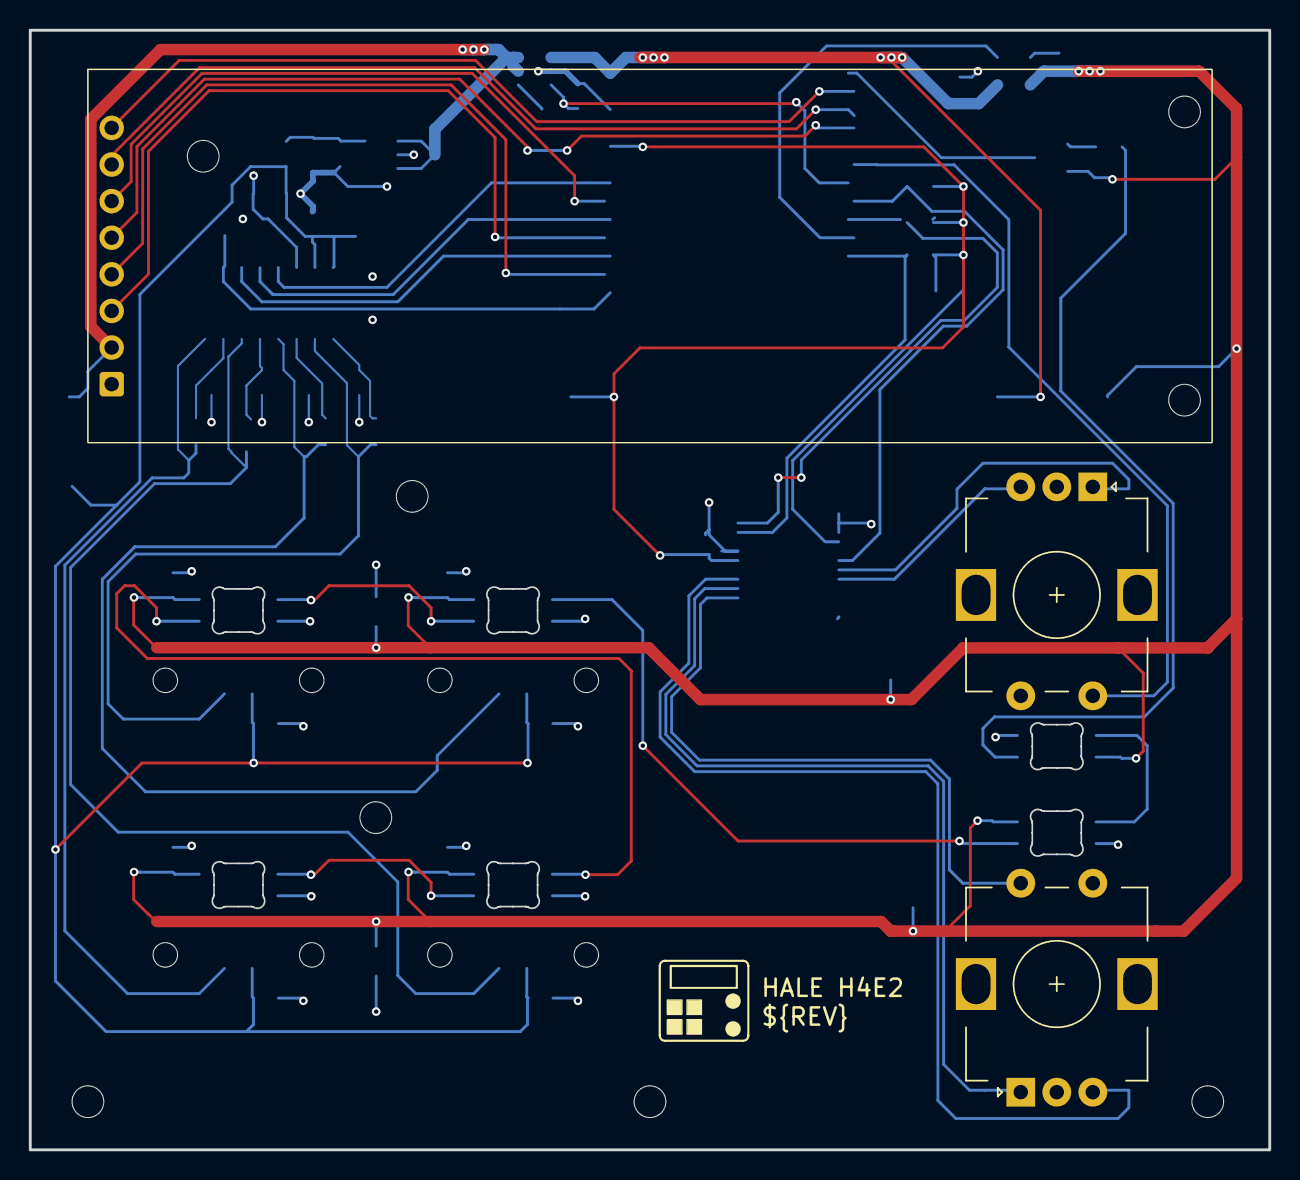
[picture p8: board H4E2.kicad_pcb from above]

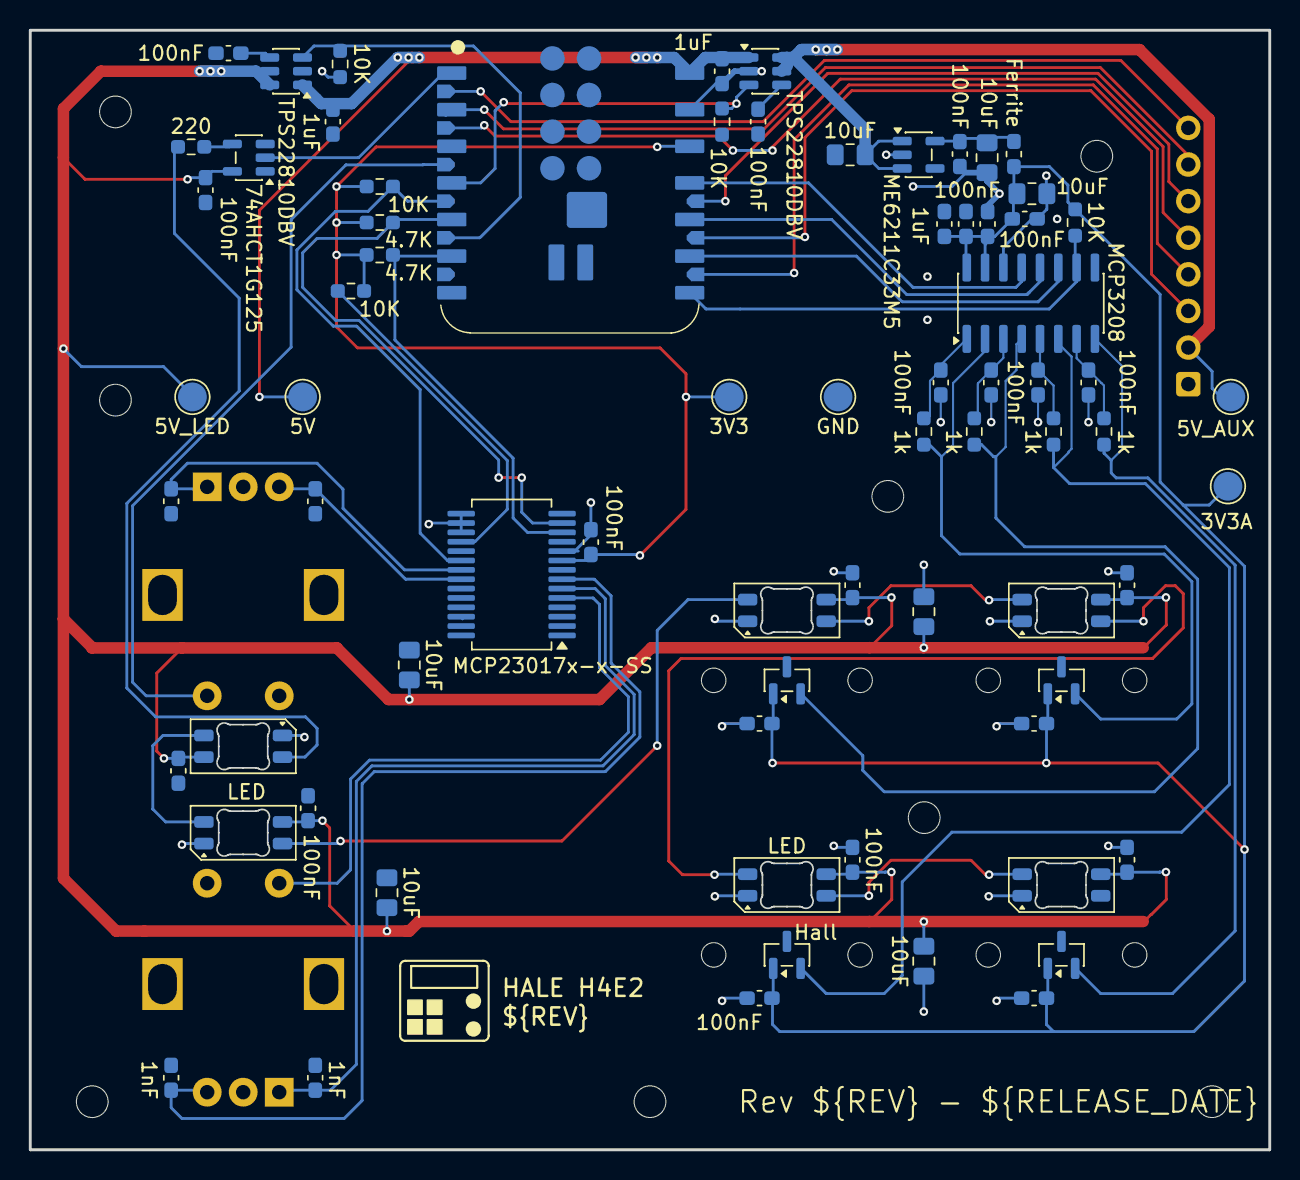
[picture p9: board H4E2.kicad_pcb from below]

Board: 2 copper layers, 86.0 x 77.7 mm, 85 parts (74 on the bottom side), 47 nets.
