tg44/HALE-H8E10/(commit log)

2026-10-09 Datasheets, 1.6 mm board, DRV5055A3 sensor, BOM fixes, FluidCAD models
    Library
    - Datasheets for every BOM part (except the Alps encoder's own sheet; the
    EC11E catalogues are in), sorted into hardware/libs/datasheets/<group>/.
    - display.md and the seller drawings moved next to the display datasheet,
    plus a product photo.
    - STEP models in hardware/libs/3dmodels/ (XIAO S3 Plus, KS-20, PEC11R,
    EC11E stand-in, the drawn display), sources in SOURCES.md.
    Decisions
    - D14: 1.6 mm board instead of 1.2 mm. The KS-20 magnet is strong (905 G
    at bottom-out); a thinner board pushes the sensor further into clipping.
    - D15: DRV5055A3 instead of SS39ET: ~1.7x signal, guaranteed ±88 mT,
    bipolar so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
2026-10-09 2.79" bar display, bolted encoders, stepped printed case sketch
    - D16: 2.79" 428×142 NV3007 bar in a strip above the keys replaces the
    1.54". Header soldered into the main PCB on 3.0 mm M2 spacers (its
    back parts are taller than the header body); VDD on 5 V so the
    backlight gets a full 3.3 V from the module's own regulator and its
    PWM current stays off the sensors' 3.3 V rail. NV3007 datasheet added
    (VCI 2.8–3.6 V, SPI write ≤ 100 MHz).
    - D17: Bourns PEC11R-4215F-S0024 only, bolted to the case top with its
    M7 nut; Alps EC11E dropped (no thread).
    - D18: panel layout and a stepped, printed top; case/layout.js is the
    source of truth, references in docs/layout-refere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
2026-10-12 2.79" display 3D model
    Exported from case/ref/display-279.part.js (FluidCAD, defaults: header
    and back-side parts on). Source and bounds in 3dmodels/SOURCES.md.
2026-10-15 lib@sha256:eee0220e91c8abd16fba91c88906bfab41865f39424b274983048235c380d94f
    footprint Display_2.79_NV3007: added
    footprint Gateron_KS-20: added
    footprint RotaryEncoder_Alps_EC12E-Switch_Vertical_H20mm: added
    footprint XIAO-ESP32-S3-Plus-SMD: added
    symbol Display_2.79_NV3007_Module: added
    symbol Gateron_KS-20: added
    symbol XIAO-ESP32-S3 Plus-SMD: added
2026-10-15 Full schematic is "done".
    hardware/kicad/HALE-H8E10.kicad_dru: Added. Gergő Törcsvári uploaded a
    new version.
    hardware/kicad/HALE-H8E10.kicad_pcb: Added. Gergő Törcsvári uploaded a
    new version.
    hardware/kicad/HALE-H8E10.kicad_pro: Added. Gergő Törcsvári changed
    document settings.
    hardware/kicad/HALE-H8E10.kicad_sch: Added. Gergő Törcsvári added 183
    wires, changed 130 wires, removed 107 wires, added 54 symbols (DS1,
    #PWR01, #PWR02, #PWR03, #PWR04, U9, …), changed 163 symbols, removed
    23 symbols, added 21 sheets, changed 159 sheets, removed 19 sheets,
    added 27 labels, changed 16 labels, removed 7 labels, added 18
    junctions, changed 18 junctions, removed 10 junctio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
2026-10-19 WIP checkpoint commit before spliting the 5V rail
    hardware/kicad/HALE-H8E10.kicad_pcb: Manufacturing: changed the board
    outline; tenting front back → -; covering - → -; plugging - → -;
    capping - → no; filling - → no; changed the plot output settings.
    Gergő Törcsvári: updated from the schematic (added C1003, C1004,
    C2001-C2016, C3001, C3002, C21001 and 83 more, TP1001-TP1003 not
    placed yet); placed C1003, C1004, C2001-C2016, C3001, C3002, C21001
    and 82 more; routed D_CS, DS_BL, DS_RES, E_INT and 86 more nets; added
    a zone on F.Cu, B.Cu; added a zone on F.Cu, B.Cu; added a zone on
    F.Cu, B.Cu; added a zone on F.Cu, B.Cu; and 15 more changes.
    hardware/kicad/HALE-H8E1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
2026-10-19 "finished" PCB
    outline. Gergő Törcsvári: updated from the schematic (added C1001,
    C1002, C1004-C1009, H1001-H1012, R1004, R1005 and 5 more; removed
    R1002 and R1003; nets changed on 44 pads); placed C1001, C1002,
    C1004-C1009, H1001-H1012, R1004, R1005 and 4 more; added REF**;
    removed C1004; moved C1003, C2002, C2003, C2006, R1001, TP2001 and
    U1001; routed EN_AUX, EN_LED, +5V_AUX, +5V_LED and 3 more nets;
    rerouted D_CS, DS_BL, DS_RES, E_INT and 21 more nets; and 3 more
    changes.
    hardware/kicad/HALE-H8E10.kicad_pro: Gergő Törcsvári excluded 2 DRC
    violations; changed schematic settings.
    hardware/kicad/HA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
2026-10-19 lib@sha256:2e133bbf16d1cb632cbb1c368a3543254f8d22031b230507526886046e3551f4
    footprint Display_2.79_NV3007: changed
    footprint Gateron_KS-20: changed
    footprint Logo H8E10: added
    footprint RotaryEncoder_Alps_EC12E-Switch_Vertical_H20mm: changed
    footprint XIAO-ESP32-S3-Plus-SMD: changed
2026-10-19 Docs synced to the routed board; datasheets for the 5 V split
    - pinout.md: XIAO table as wired (LCD_CS, EN_AUX, ADC_CS on GPIO44,
    INT_EXP, EN_LED, ENC6_SW), 18 GPIO used, expander map bit by bit,
    ADC channel and LED chain order.
    - bom.md: schematic designators, LCSC numbers checked and linked,
    TPS22810 added, 220 uF bulk dropped, inserts/screws/header.
    - pcb-notes.md: 5 V rails and firmware rules, CS pull-ups, XIAO
    placement, display on 5V_AUX, mounting holes, silkscreen, test points.
    - decisions.md: D23 (5 V split into switched rails), D24 (mounting holes).
    - plan.md: verified footprint checks and layout steps ticked.
    - Datasheets: TPS22810, TPS22810-Q1, TPS22918, Uni-Royal 4D03 arr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
2026-10-22 rev, and minor adjustements
    hardware/kicad/HALE-H8E10.kicad_pcb: Gergő Törcsvári moved K21001,
    K22001, K23001, K24001, K25001, K26001, K27001 and K28001; title
    block: date - → ${RELEASE_DATE}, rev - → ${REV}, title - → HALE-H8E10;
    tidied the silkscreen.
    hardware/kicad/HALE-H8E10.kicad_pro: Manufacturing: changed the IPC-2581
    settings. Gergő Törcsvári: RELEASE_DATE - → 2026-10-20; REV - → 1.0;
    changed schematic settings.
    hardware/kicad/HALE-H8E10.kicad_sch: Gergő Törcsvári title block: date
    2026-10-12 → ${RELEASE_DATE}, rev A → ${REV}.
    hardware/kicad/encoder.kicad_sch: Gergő Törcsvári changed 10 parts'
    fields.
    hardware/kicad/key_cell.kicad_sch: Gergő T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
2026-10-22 Update HALE-git: 5 changed
    footprint Logo H8E10: changed
    PCBJam-Lib-Revision: sha256:268ff15f456f7a1ab09322bb218d5462441e04485756c26e906da2fe159ee18a
    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
2026-10-22 folder rename
    hardware/H8E10/.gitkeep: Renamed from hardware/kicad/.gitkeep. Gergő
    Törcsvári renamed the file.
    hardware/H8E10/HALE-H8E10.kicad_dru: Renamed from
    hardware/kicad/HALE-H8E10.kicad_dru. Gergő Törcsvári renamed the file.
    hardware/H8E10/HALE-H8E10.kicad_pcb: Renamed from
    hardware/kicad/HALE-H8E10.kicad_pcb. Gergő Törcsvári renamed the file.
    hardware/H8E10/HALE-H8E10.kicad_pro: Renamed from
    hardware/kicad/HALE-H8E10.kicad_pro. Gergő Törcsvári renamed the file.
    hardware/H8E10/HALE-H8E10.kicad_sch: Renamed from
    hardware/kicad/HALE-H8E10.kicad_sch. Gergő Törcsvári renamed the file.
    hardware/H8E10/encoder.kicad_sch: Renamed from
    hardware/kicad/encoder.kicad_sc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
2026-10-24 Firmware docs: toolchain, USB plan, feature folders, bring-up order
    - D25: C++ on PlatformIO + pioarduino (pinned), Arduino framework;
    USB-MIDI switched on last after OTA, with an early C1 spike
    - firmware/AGENTS.md (+ CLAUDE.md import): rules for feature folders,
    test/check IDs, check tables, task lists
    - firmware/docs: toolchain, usb, features overview, bring-up order, and
    stubs for system, leds, display, encoders, keys, midi, settings, web
    - settings-mode proposal moved into features/settings
    - plan.md track C links to the feature docs; GPIO43 debug pad as an open
    Track A item; CLAUDE.md: 18 LEDs, current project stage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
2026-10-25 H4E2: copy of the H8E10 KiCad project as the mini starting point
2026-10-25 Case: shared lib, H4E2 mini layouts, LED windows, mini assembly
    - case/ reorganised: shared part sizes and builders in case/lib/, the
    full board in case/h8e10/ (same geometry as before), the mini in
    case/mini/ with 1-4 encoder variants; h4e2-stack picked and centred
    - encoder LED windows: two-material sandwich (rectangular transparent
    plug bridging its light channel); the encoder area of the top is
    solid with encoder pockets and a channel per LED
    - mini assembly (D27): top on the tray walls, two screws into heat-set
    inserts on the right plus the encoder nuts, PCB on tray towers with
    two locating pins
    - docs: D26 (mini test board before v0, amends D12), D27; CLAUDE.md,
    READMEs,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
2026-10-25 Logo H4E2 footprint: the mini board at 1:14, like Logo H8E10
    Outline, display window, 2x2 keys and the two stacked encoders from
    case/mini/layout.js (h4e2-stack), name and ${REVISION} to the right.
    Plan: add it to the HALE-git library in pcbjam and place it.
2026-10-26 H4E2 "final" design.
    hardware/H4E2/H4E2.kicad_pcb: Manufacturing: changed the board outline.
    Gergő Törcsvári: updated from the schematic (added C1008, C1009,
    H1005, R2002-R2005, TP1001, TP1003 and TP1004; removed C2004, C2008,
    C2010, C2013, C3002, C23001 and 47 more; nets changed on 28 pads);
    placed C1008, C1009, C3001, C31001-C31003, C36001-C36003, D31001 and
    10 more; added REF**; removed C1008, C1009, H1005, LogoB, LogoF,
    TP1001, TP1003 and TP1004; moved C1003, H1004, R1001, TP1002, TP1005,
    TP2001 and U1001; flipped H1012 to the bottom; routed
    encoders/ENC_SW6, Net-(U2002-CH0), Net-(U2002-CH2), Net-(U2002-CH4)
    and 2 more nets; and 17 more changes.
    hardware/H4E2/H4E2.ki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
